msmttng/nyuten-tsd10-manual/README.md

# 入店チャイム センサー箱 TSD10版（r4）実写図解・作成マニュアル

- 🌐 **Webマニュアルサイト（PC・スマホ・タブレット対応）**: https://msmttng.github.io/nyuten-tsd10-manual/
- 📶 **Wi-Fi経由アップデート用 `.mpy` 直リンク（最新版3.1）**: [https://msmttng.github.io/nyuten-tsd10-manual/downloads/sensor_tsd10_v3.1.mpy](https://msmttng.github.io/nyuten-tsd10-manual/downloads/sensor_tsd10_v3.1.mpy)
- 🔌 **Wi-Fi更新 ＆ ソフト一式ダウンロード・ブラウザ直接書き込みツール（版3.1）**: [https://msmttng.github.io/nyuten-tsd10-manual/flash.html](https://msmttng.github.io/nyuten-tsd10-manual/flash.html)
- 📦 **TSD10版 ソフト一式 ZIP 直リンク（版3.1）**: [https://msmttng.github.io/nyuten-tsd10-manual/downloads/TSD10_v3.1_full_set.zip](https://msmttng.github.io/nyuten-tsd10-manual/downloads/TSD10_v3.1_full_set.zip)
- 🖨️ **A4印刷用PDF（全6ページ）**: [https://msmttng.github.io/nyuten-tsd10-manual/manual_a4.pdf](https://msmttng.github.io/nyuten-tsd10-manual/manual_a4.pdf)
- 📦 **本体 STL（印刷向き・サポート不要）**: [https://msmttng.github.io/nyuten-tsd10-manual/tsd10_body_print.stl](https://msmttng.github.io/nyuten-tsd10-manual/tsd10_body_print.stl)
- 📦 **ふた STL（印刷向き・サポート不要）**: [https://msmttng.github.io/nyuten-tsd10-manual/tsd10_lid_print.stl](https://msmttng.github.io/nyuten-tsd10-manual/tsd10_lid_print.stl)
