msmttng/nyuten-tsd10-manual/tsd10_body_print.stl

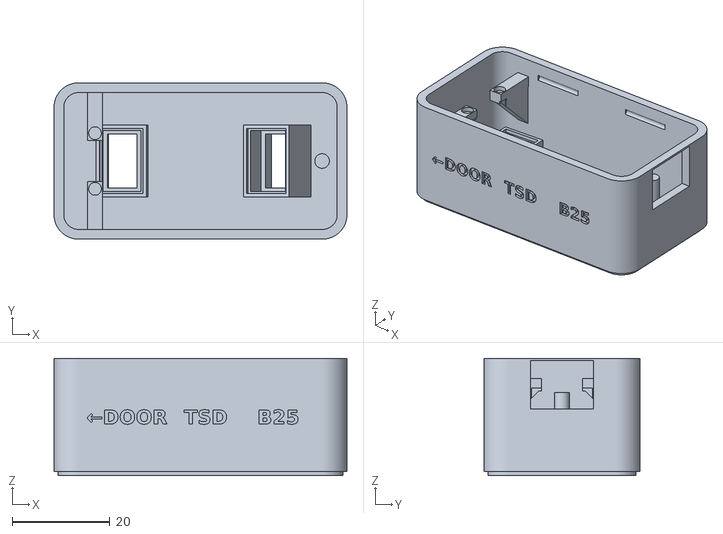
[picture p1: CAD file, 2026-10-29]
tsd10_body_print.stl
60.0 x 32.0 x 24.0
