msmttng/nyuten-tsd10-manual/tsd10_lid_print.stl

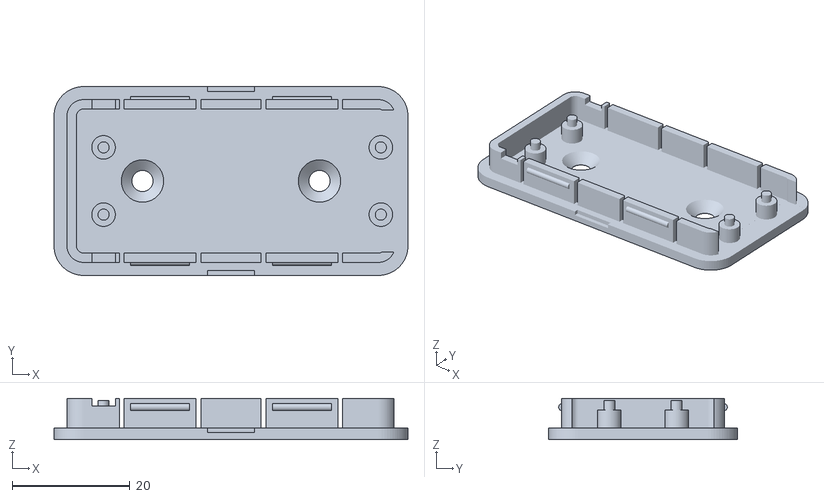
[picture p2: CAD file, 2026-10-29]
tsd10_lid_print.stl
60.0 x 32.0 x 7.00
