msmttng/nyuten-tsd10-manual/manual_a4.pdf

## 入店チャイム センサー箱 TSD10版（r4）作成マニュアル

STEP 1 用意するもの（実際の使用部品と工具） | 図1：部品・部材一覧

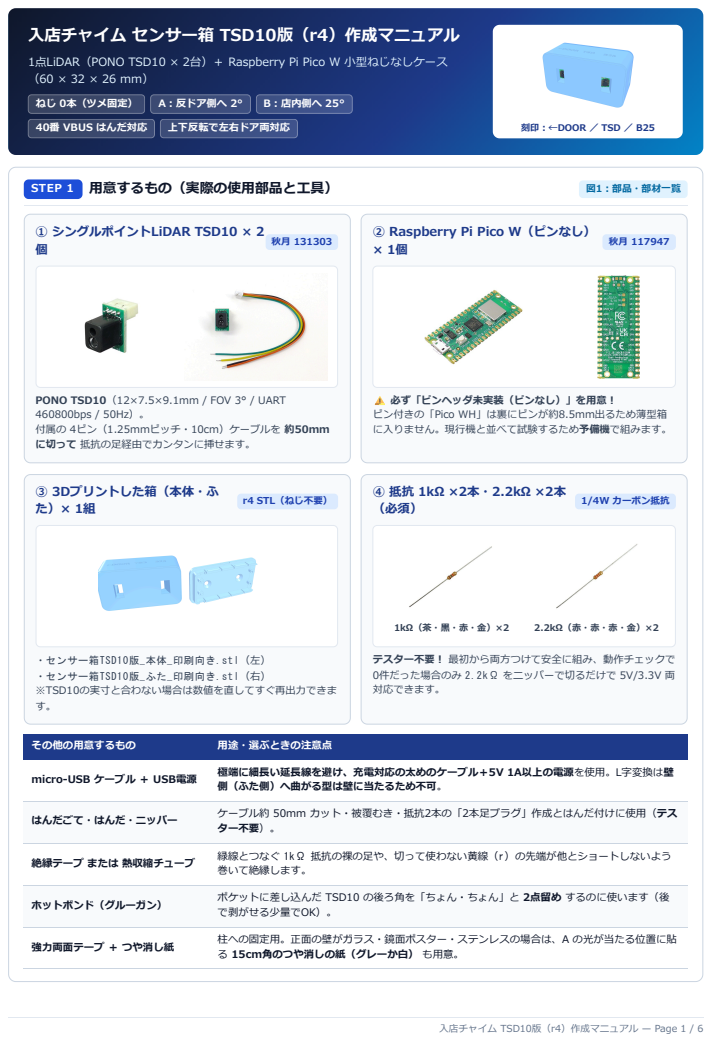
[picture p3: page 1]
ねじ 0本（ツメ固定）; A：反ドア側へ 2°; B：店内側へ 25°; 40番 VBUS はんだ対応; 上下反転で左右ドア両対応; 刻印：←DOOR ／ TSD ／ B25; ① シングルポイントLiDAR TSD10 × 2 個; ③ 3Dプリントした箱（本体・ふ た）× 1組; r4 STL（ねじ不要）; ・センサー箱TSD10版_本体_印刷向き.stl（左）; ・センサー箱TSD10版_ふた_印刷向き.stl（右） ※TSD10の実寸と合わない場合は数値を直してすぐ再出力できま す。; 1/4W カーボン抵抗; 入店チャイム TSD10版（r4）作成マニュアル —; Page 1 / 6

1点LiDAR（PONO TSD10 × 2台）＋ Raspberry Pi Pico W 小型ねじなしケース

② Raspberry Pi Pico W（ピンなし）

PONO TSD10（12×7.5×9.1mm / FOV 3° / UART
460800bps / 50Hz）。
付属の 4ピン（1.25mmピッチ・10cm）ケーブルを 約50mm
に切って 抵抗の足経由でカンタンに挿せます。

⚠️ 必ず「ピンヘッダ未実装（ピンなし）」を用意！
ピン付きの「Pico WH」は裏にピンが約8.5mm出るため薄型箱
に入りません。現行機と並べて試験するため予備機で組みます。

テスター不要！ 最初から両方つけて安全に組み、動作チェックで
0件だった場合のみ 2.2kΩ をニッパーで切るだけで 5V/3.3V 両
対応できます。

その他の用意するもの | 用途・選ぶときの注意点
micro-USB ケーブル ＋ USB電源 | 極端に細長い延長線を避け、充電対応の太めのケーブル＋5V 1A以上の電源を使用。L字変換は壁 側（ふた側）へ曲がる型は壁に当たるため不可。

はんだごて・はんだ・ニッパー | ケーブル約 50mm カット・被覆むき・抵抗2本の「2本足プラグ」作成とはんだ付けに使用（テス ター不要）。

絶縁テープ または 熱収縮チューブ | 緑線とつなぐ 1kΩ 抵抗の裸の足や、切って使わない黄線（r）の先端が他とショートしないよう 巻いて絶縁します。

ホットボンド（グルーガン） | ポケットに差し込んだ TSD10 の後ろ角を「ちょん・ちょん」と 2点留め するのに使います（後 で剥がせる少量でOK）。

強力両面テープ ＋ つや消し紙 | 柱への固定用。正面の壁がガラス・鏡面ポスター・ステンレスの場合は、A の光が当たる位置に貼 る 15cm角のつや消しの紙（グレーか白） も用意。

STEP 2 箱の 3Dプリント（印刷の向きと仮合わせ） | 図2：ビルドプレート上の向き

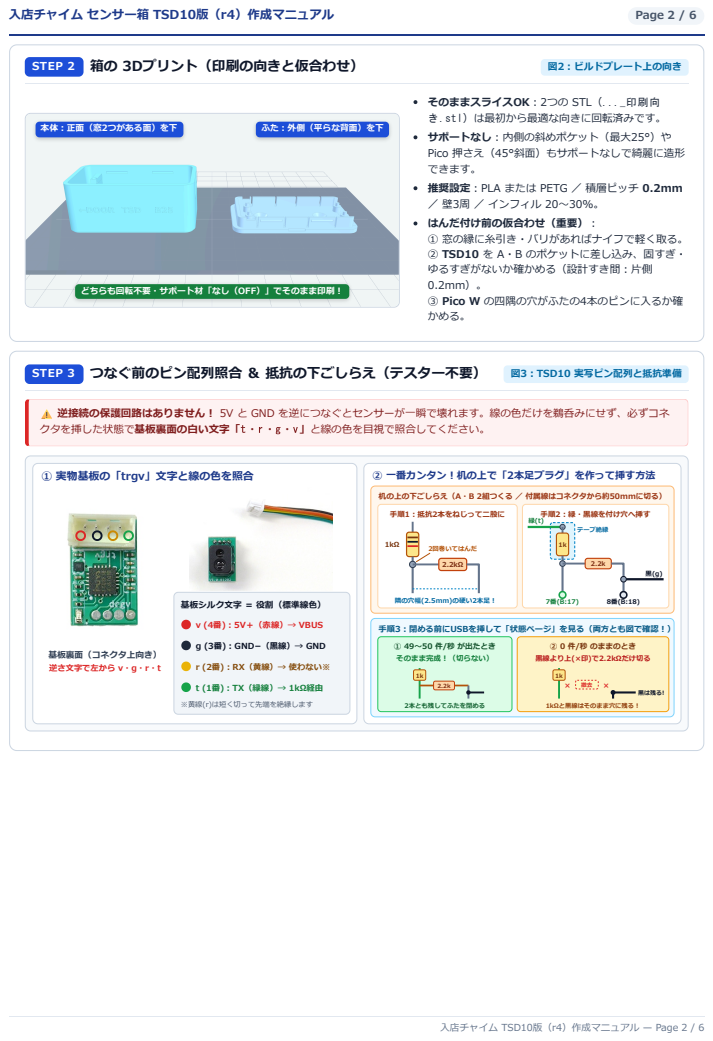
[picture p4: page 2]
入店チャイム センサー箱 TSD10版（r4）作成マニュアル; Page 2 / 6; 基板裏面（コネクタ上向き） 逆さ文字で左から v・g・r・t; 机の上の下ごしらえ（A・B 2組つくる ／ 付属線はコネクタから約50mmに切る）; 手順1：抵抗2本をねじって二股に; 2回巻いてはんだ; 隣の穴幅(2.5mm)の硬い2本足！; 手順2：緑・黒線を付け穴へ挿す; テープ絶縁; 2本とも残してふたを閉める; ② 0 件/秒 のままのとき 黒線より上(×印)で2.2kΩだけ切る; 黒は残る!; 1kΩと黒線はそのまま穴に残る！; 本体：正面（窓2つがある面）を下; ふた：外側（平らな背面）を下

そのままスライスOK：2つの STL（..._印刷向
き.stl）は最初から最適な向きに回転済みです。
サポートなし：内側の斜めポケット（最大25°）や
Pico 押さえ（45°斜面）もサポートなしで綺麗に造形
できます。
推奨設定：PLA または PETG ／ 積層ピッチ 0.2mm
／ 壁3周 ／ インフィル 20〜30%。
はんだ付け前の仮合わせ（重要）：
① 窓の縁に糸引き・バリがあればナイフで軽く取る。
② TSD10 を A・B のポケットに差し込み、固すぎ・
ゆるすぎがないか確かめる（設計すき間：片側
③ Pico W の四隅の穴がふたの4本のピンに入るか確
かめる。

どちらも回転不要・サポート材「なし（OFF）」でそのまま印刷！

STEP 3 つなぐ前のピン配列照合 ＆ 抵抗の下ごしらえ（テスター不要） 図3：TSD10 実写ピン配列と抵抗準備

⚠️ 逆接続の保護回路はありません！ 5V と GND を逆につなぐとセンサーが一瞬で壊れます。線の色だけを鵜呑みにせず、必ずコネ
クタを挿した状態で基板裏面の白い文字「t・r・g・v」と線の色を目視で照合してください。

① 実物基板の「trgv」文字と線の色を照合

② 一番カンタン！机の上で「2本足プラグ」を作って挿す方法

基板シルク文字 ＝ 役割（標準線色）
v (4番)：5V＋（赤線）→ VBUS
g (3番)：GND−（黒線）→ GND
r (2番)：RX（黄線）→ 使わない※
t (1番)：TX（緑線）→ 1kΩ経由
※黄線(r)は短く切って先端を絶縁します

手順3：閉める前にUSBを挿して「状態ページ」を見る（両方とも図で確認！）
① 49〜50 件/秒 が出たとき
そのまま完成！（切らない）

## STEP 4 配線とはんだ付け（実写ピンマップ・2本足プラグ方式） 図4：テスター不要の抵抗込み実体配線図

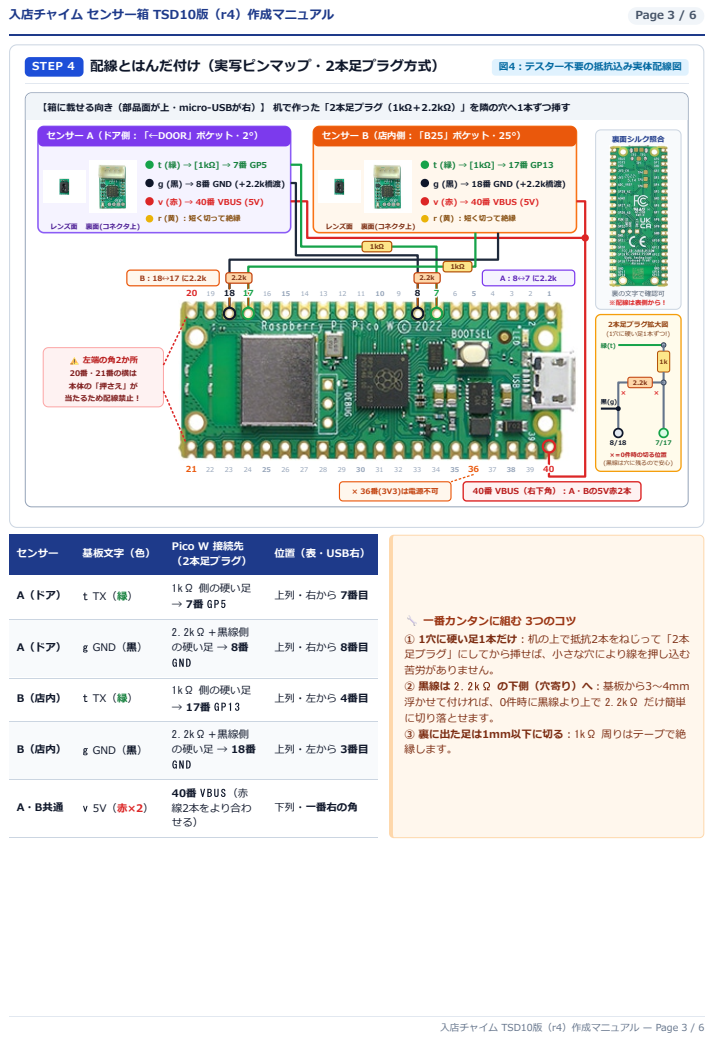
[picture p5: page 3]
入店チャイム センサー箱 TSD10版（r4）作成マニュアル; Page 3 / 6; レンズ面; 裏面(コネクタ上); t (緑) → [1kΩ] → 7番 GP5 g (黒) → 8番 GND (+2.2k橋渡) v (赤) → 40番 VBUS (5V); r (黄) ：短く切って絶縁; t (緑) → [1kΩ] → 17番 GP13 g (黒) → 18番 GND (+2.2k橋渡) v (赤) → 40番 VBUS (5V); ⚠️ 左端の角2か所 20番・21番の横は 本体の「押さえ」が 当たるため配線禁止！; × 36番(3V3)は電源不可; 40番 VBUS（右下角）：A・Bの5V赤2本; 裏面シルク照合; 裏の文字で確認可 ※配線は表側から！; 2本足プラグ拡大図 (1穴に硬い足1本ずつ!) 緑(t); ×＝0件時の切る位置 (黒線は穴に残るので安心)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

【箱に載せる向き（部品面が上・micro-USBが右）】 机で作った「2本足プラグ（1kΩ＋2.2kΩ）」を隣の穴へ1本ずつ挿す

センサー A（ドア側：「←DOOR」ポケット・2°）

センサー B（店内側：「B25」ポケット・25°）

センサー | 基板文字（色） | Pico W 接続先 （2本足プラグ） | 位置（表・USB右）

A（ドア） | t TX（緑） | 1kΩ 側の硬い足 → 7番 G P 5 | 上列・右から 7番目

A（ドア） | g GND（黒） | 2.2kΩ＋黒線側 の硬い足 → 8番 G N D | 上列・右から 8番目

B（店内） | t TX（緑） | 1kΩ 側の硬い足 → 17番 G P 1 3 | 上列・左から 4番目

B（店内） | g GND（黒） | 2.2kΩ＋黒線側 の硬い足 → 18番 G N D | 上列・左から 3番目

A・B共通 | v 5V（赤×2） | 40番 V B U S（赤 線2本をより合わ せる） | 下列・一番右の角

## STEP 5 TSD10 を本体のポケットへ差し込み・ホットボンド2点留め 図5：ポケット差し込みと角度断面

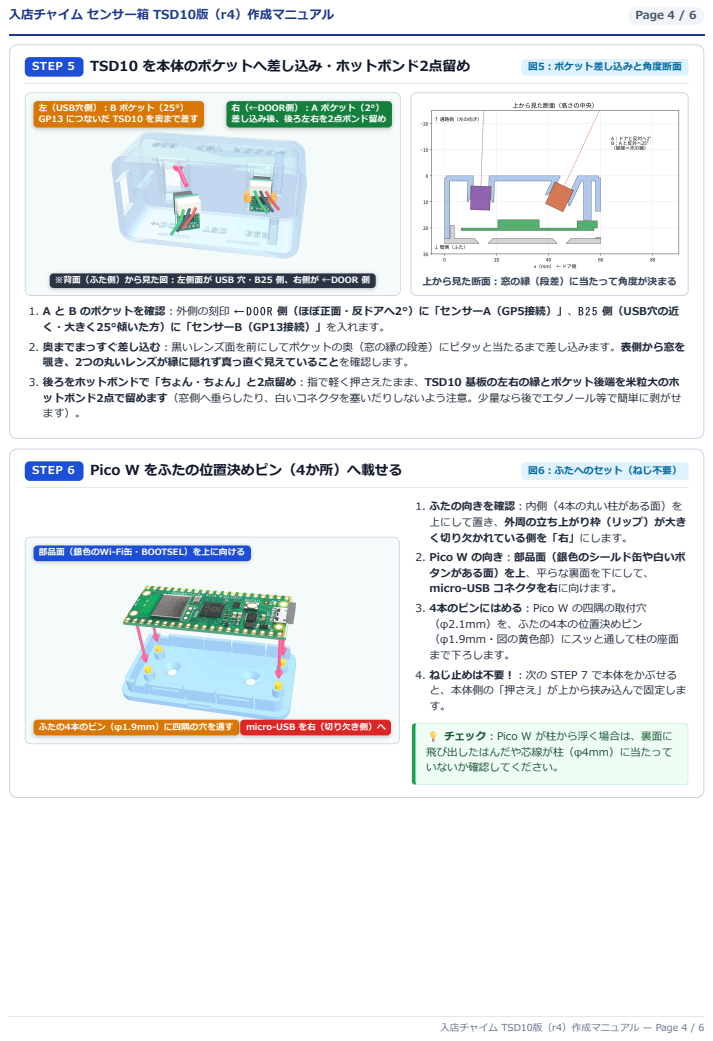
[picture p6: page 4]
入店チャイム センサー箱 TSD10版（r4）作成マニュアル; Page 4 / 6; STEP 6 Pico W をふたの位置決めピン（4か所）へ載せる; 図6：ふたへのセット（ねじ不要）; 左（USB穴側）：B ポケット（25°） GP13 につないだ TSD10 を奥まで差す; 右（←DOOR側）：A ポケット（2°） 差し込み後、後ろ左右を2点ボンド留め; ※背面（ふた側）から見た図：左側面が USB 穴・B25 側、右側が ←DOOR 側; 上から見た断面：窓の縁（段差）に当たって角度が決まる; ふたの4本のピン（φ1.9mm）に四隅の穴を通す; micro-USB を右（切り欠き側）へ

1. A と B のポケットを確認：外側の刻印 ←DOOR 側（ほぼ正面・反ドアへ2°）に「センサーA（GP5接続）」、B25 側（USB穴の近
く・大きく25°傾いた方）に「センサーB（GP13接続）」を入れます。
2. 奥までまっすぐ差し込む：黒いレンズ面を前にしてポケットの奥（窓の縁の段差）にピタッと当たるまで差し込みます。表側から窓を
覗き、2つの丸いレンズが縁に隠れず真っ直ぐ見えていることを確認します。
3. 後ろをホットボンドで「ちょん・ちょん」と2点留め：指で軽く押さえたまま、TSD10 基板の左右の縁とポケット後端を米粒大のホ
ットボンド2点で留めます（窓側へ垂らしたり、白いコネクタを塞いだりしないよう注意。少量なら後でエタノール等で簡単に剥がせ

1. ふたの向きを確認：内側（4本の丸い柱がある面）を
上にして置き、外周の立ち上がり枠（リップ）が大き
く切り欠かれている側を「右」にします。
2. Pico W の向き：部品面（銀色のシールド缶や白いボ
タンがある面）を上、平らな裏面を下にして、
micro-USB コネクタを右に向けます。
3. 4本のピンにはめる：Pico W の四隅の取付穴
（φ2.1mm）を、ふたの4本の位置決めピン
（φ1.9mm・図の黄色部）にスッと通して柱の座面
まで下ろします。
4. ねじ止めは不要！：次の STEP 7 で本体をかぶせる
と、本体側の「押さえ」が上から挟み込んで固定しま

部品面（銀色のWi-Fi缶・BOOTSEL）を上に向ける

💡 チェック：Pico W が柱から浮く場合は、裏面に
飛び出したはんだや芯線が柱（φ4mm）に当たって
いないか確認してください。

STEP 7 閉める前の10秒通電チェック ＆ ふたをカチッと閉める | 図7：通電判定とスナップ合体

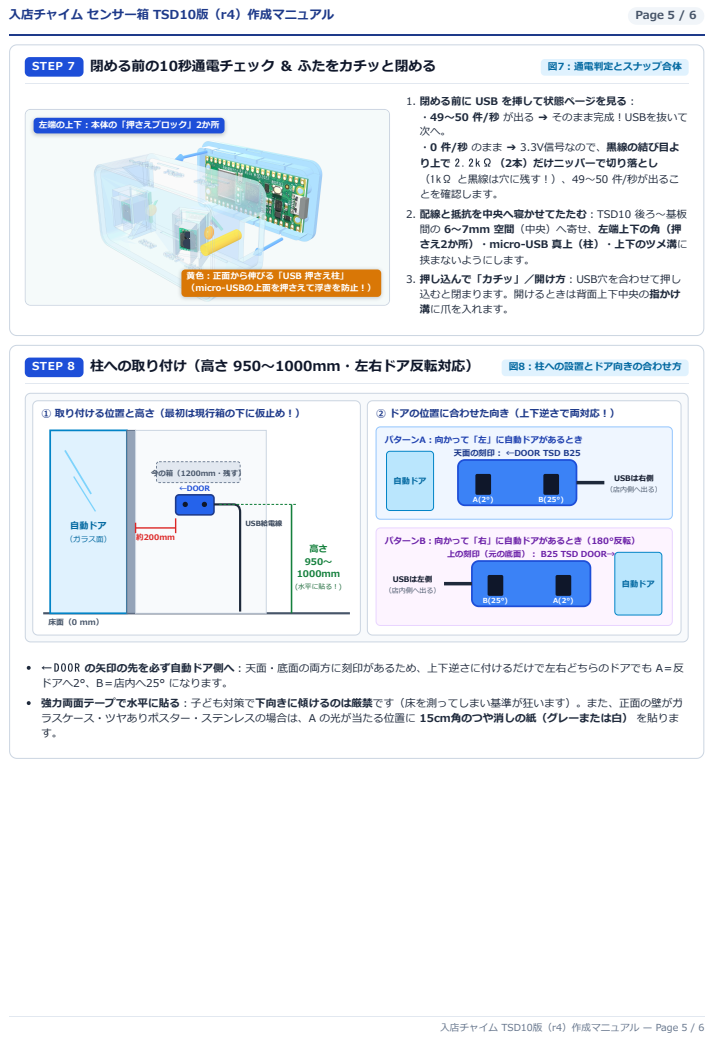
[picture p7: page 5]
入店チャイム センサー箱 TSD10版（r4）作成マニュアル; Page 5 / 6; STEP 8 柱への取り付け（高さ 950〜1000mm・左右ドア反転対応）; 図8：柱への設置とドア向きの合わせ方; ① 取り付ける位置と高さ（最初は現行箱の下に仮止め！）; 自動ドア （ガラス面）; 今の箱（1200mm・残す） ←DOOR; USB給電線; 高さ 950〜 1000mm (水平に貼る！); ② ドアの位置に合わせた向き（上下逆さで両対応！）; 自動ドア; 天面の刻印：; ←DOOR TSD B25; USBは右側 （店内側へ出る）; 上の刻印（元の底面）：; B25 TSD DOOR→; USBは左側 （店内側へ出る）

1. 閉める前に USB を挿して状態ページを見る：
・49〜50 件/秒 が出る ➔ そのまま完成！USBを抜いて
・0 件/秒 のまま ➔ 3.3V信号なので、黒線の結び目よ
り上で 2 . 2 kΩ （2本）だけニッパーで切り落とし
（1kΩ と黒線は穴に残す！）、49〜50 件/秒が出るこ
とを確認します。
2. 配線と抵抗を中央へ寝かせてたたむ：TSD10 後ろ〜基板
間の 6〜7mm 空間（中央）へ寄せ、左端上下の角（押
さえ2か所）・micro-USB 真上（柱）・上下のツメ溝に
挟まないようにします。
3. 押し込んで「カチッ」／開け方：USB穴を合わせて押し
込むと閉まります。開けるときは背面上下中央の指かけ
溝に爪を入れます。

左端の上下：本体の「押さえブロック」2か所

黄色：正面から伸びる「USB 押さえ柱」
（micro-USBの上面を押さえて浮きを防止！）

パターンA：向かって「左」に自動ドアがあるとき

パターンB：向かって「右」に自動ドアがあるとき（180°反転）

←DOOR の矢印の先を必ず自動ドア側へ：天面・底面の両方に刻印があるため、上下逆さに付けるだけで左右どちらのドアでも A＝反
ドアへ2°、B＝店内へ25° になります。
強力両面テープで水平に貼る：子ども対策で下向きに傾けるのは厳禁です（床を測ってしまい基準が狂います）。また、正面の壁がガ
ラスケース・ツヤありポスター・ステンレスの場合は、A の光が当たる位置に 15cm角のつや消しの紙（グレーまたは白） を貼りま

## STEP 9 光の向きの確認（上から見た通路全体とレーザー通り道チェック） 図9：ビーム俯瞰図と外乱チェック

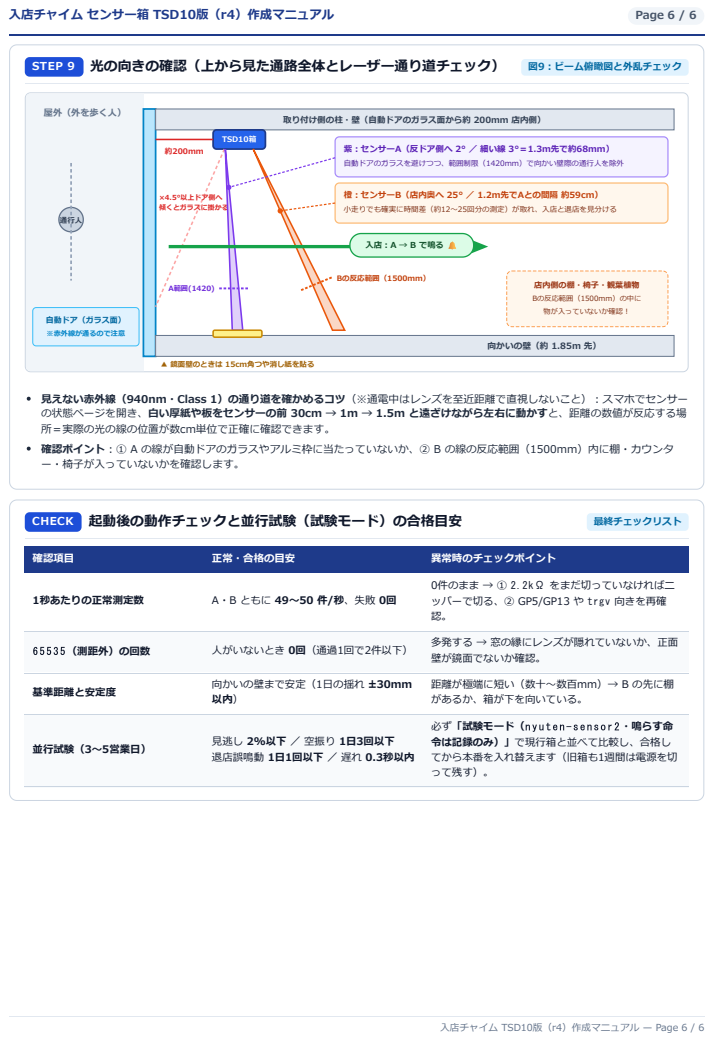
[picture p8: page 6]
入店チャイム センサー箱 TSD10版（r4）作成マニュアル; Page 6 / 6; 屋外（外を歩く人）; 通行人; 自動ドア（ガラス面） ※赤外線が通るので注意; 向かいの壁（約 1.85m 先）; TSD10箱; ×4.5°以上ドア側へ 傾くとガラスに掛かる; ▲ 鏡面壁のときは 15cm角つや消し紙を貼る; A範囲(1420); Bの反応範囲（1500mm）; 入店：A → B で鳴る 🔔; CHECK 起動後の動作チェックと並行試験（試験モード）の合格目安; 最終チェックリスト

取り付け側の柱・壁（自動ドアのガラス面から約 200mm 店内側）

紫：センサーA（反ドア側へ 2° ／ 細い線 3°＝1.3m先で約68mm）
自動ドアのガラスを避けつつ、範囲制限（1420mm）で向かい壁際の通行人を除外

橙：センサーB（店内奥へ 25° ／ 1.2m先でAとの間隔 約59cm）
小走りでも確実に時間差（約12〜25回分の測定）が取れ、入店と退店を見分ける

店内側の棚・椅子・観葉植物
Bの反応範囲（1500mm）の中に
物が入っていないか確認！

見えない赤外線（940nm・Class 1）の通り道を確かめるコツ（※通電中はレンズを至近距離で直視しないこと）：スマホでセンサー
の状態ページを開き、白い厚紙や板をセンサーの前 30cm → 1m → 1.5m と遠ざけながら左右に動かすと、距離の数値が反応する場
所＝実際の光の線の位置が数cm単位で正確に確認できます。
確認ポイント：① A の線が自動ドアのガラスやアルミ枠に当たっていないか、② B の線の反応範囲（1500mm）内に棚・カウンタ
ー・椅子が入っていないかを確認します。

確認項目 | 正常・合格の目安 | 異常時のチェックポイント
1秒あたりの正常測定数 | A・B ともに 49〜50 件/秒、失敗 0回 | 0件のまま → ① 2.2kΩ をまだ切っていなければニ ッパーで切る、② GP5/GP13 や trgv 向きを再確 認。

6 5 5 3 5（測距外）の回数 | 人がいないとき 0回（通過1回で2件以下） | 多発する → 窓の縁にレンズが隠れていないか、正面 壁が鏡面でないか確認。

基準距離と安定度 | 向かいの壁まで安定（1日の揺れ ±30mm 以内） | 距離が極端に短い（数十〜数百mm）→ B の先に棚 があるか、箱が下を向いている。

並行試験（3〜5営業日） | 見逃し 2%以下 ／ 空振り 1日3回以下 退店誤鳴動 1日1回以下 ／ 遅れ 0.3秒以内 | 必ず「試験モード（n y u t e n - s e n s o r 2・鳴らす命 令は記録のみ）」で現行箱と並べて比較し、合格し てから本番を入れ替えます（旧箱も1週間は電源を切 って残す）。
