msmttng/nyuten-tsd10-manual/(commit log)

2026-10-29 [nyuten-tsd10-manual] 入店チャイム センサー箱 TSD10版(r4) 作成マニュアルサイトを公開
    [tsd10_body_print.stl, tsd10_lid_print.stl]
2026-10-30 [nyuten-tsd10-manual] テスター不要の抵抗標準組み込み・ニッパー切替手順へマニュアル一式を差し替え
2026-10-30 [nyuten-tsd10-manual] 一番カンタンな2本足プラグ方式＆2通り比較のカラー図解へWebサイトとA4 PDFを更新
2026-10-30 [nyuten-tsd10-manual] 別PC向けソフト一式ZIP配布＆ブラウザ直接書き込みツールを追加
2026-10-30 [nyuten-tsd10-manual] TSD10版3.1（Wi-Fi 2件自動切替・Wi-Fi経由OTA更新・2.18全機能統合）を公開
2026-10-30 [nyuten-tsd10-manual] Claude引き継ぎ用パッケージ（版3.1・機密ゼロ）のDLリンクを追加
